JWehle/gps-seven-seg-clock/README.md

# gps-seven-seg-clock
A large seven segment clock that uses highly accurate GPS time.
