JWehle/gps-seven-seg-clock/gps-seven-seg-clock.xlsx

Reference | Qty | Value | Footprint
C1,C2,C5,C6,C8,C9,C10,C11,C13,C15,C16,C17 | 12 | 0.1uF | Capacitor_SMD:C_0603_1608Metric
C3 | 1 | 10nF | Capacitor_SMD:C_0603_1608Metric
C4,C12,C14 | 3 | 10uF | Capacitor_SMD:C_0603_1608Metric
C7 | 1 | 100uF | Capacitor_SMD:CP_Elec_6.3x5.4_Nichicon
D1 | 1 | RED LED | LED_SMD:LED_0603_1608Metric_Pad1.05x0.95mm_HandSolder
D2,D3 | 2 | B5819W | Diode_SMD:D_SOD-123
J1 | 1 | SMA | Connector_Coaxial:SMA_Amphenol_132289_EdgeMount
J2,J3,J7,J8,J10,J11 | 6 | SM09B-GHS-TB | Connector_JST:JST_GH_SM09B-GHS-TB_1x09-1MP_P1.25mm_Horizontal
J5 | 1 | XT30PW-M | Connector_AMASS:AMASS_XT30PW-M_1x02_P2.50mm_Horizontal
J6,J12 | 2 | SM04B-GHS-TB | Connector_JST:JST_GH_SM04B-GHS-TB_1x04-1MP_P1.25mm_Horizontal
J9 | 1 | SM06B-GHS-TB | Connector_JST:JST_GH_SM06B-GHS-TB_1x06-1MP_P1.25mm_Horizontal
L1 | 1 | ferrite | Inductor_SMD:L_0805_2012Metric_Pad1.15x1.40mm_HandSolder
Q2 | 1 | MJD127 | Package_TO_SOT_SMD:TO-252-2
R1 | 1 | 10R | Resistor_SMD:R_0603_1608Metric
R2,R3,R4,R5 | 4 | 2.2K | Resistor_SMD:R_0603_1608Metric
R6,R8,R9,R10 | 4 | 100K | Resistor_SMD:R_0603_1608Metric
R7,R14,R15 | 3 | 1K | Resistor_SMD:R_0603_1608Metric
R11,R16 | 2 | 10K | Resistor_SMD:R_0603_1608Metric
R12 | 1 | 4.99K | Resistor_SMD:R_0603_1608Metric
R13,R17 | 2 | 470R | Resistor_SMD:R_1206_3216Metric
SW1 | 1 | 219-2LPST | Button_Switch_SMD:SW_DIP_SPSTx02_Slide_6.7x6.64mm_W8.61mm_P2.54mm_LowProfile
TP1,TP2,TP3,TP4 | 4 | testpoint5016 | jannett_footprints:TestPoint_Keystone_5016_Vias
U1,U6,U11 | 3 | CAT9555PW | Package_SO:TSSOP-24_4.4x7.8mm_P0.65mm
U2 | 1 | MAX-M10S | RF_GPS:ublox_MAX
U3,U4,U7,U8,U12,U13 | 6 | ULN2003ADR | Package_SO:SOIC-16_3.9x9.9mm_P1.27mm
U5 | 1 | ATmega328PB-A | Package_QFP:TQFP-32_7x7mm_P0.8mm
U9 | 1 | NCP1117-3.3_TO252 | Package_TO_SOT_SMD:TO-252-2
U10 | 1 | AD8676xR | Package_SO:SOIC-8_3.9x4.9mm_P1.27mm
Y1 | 1 | 8MHz | Crystal:Resonator_SMD_Murata_CSTxExxV-3Pin_3.0x1.1mm_HandSoldering
