JWehle/gps-seven-seg-clock/gps-seven-seg-clock-v2.kicad_pcb

## KiCad design gps-seven-seg-clock-v2.kicad_pcb (2026-03-17)

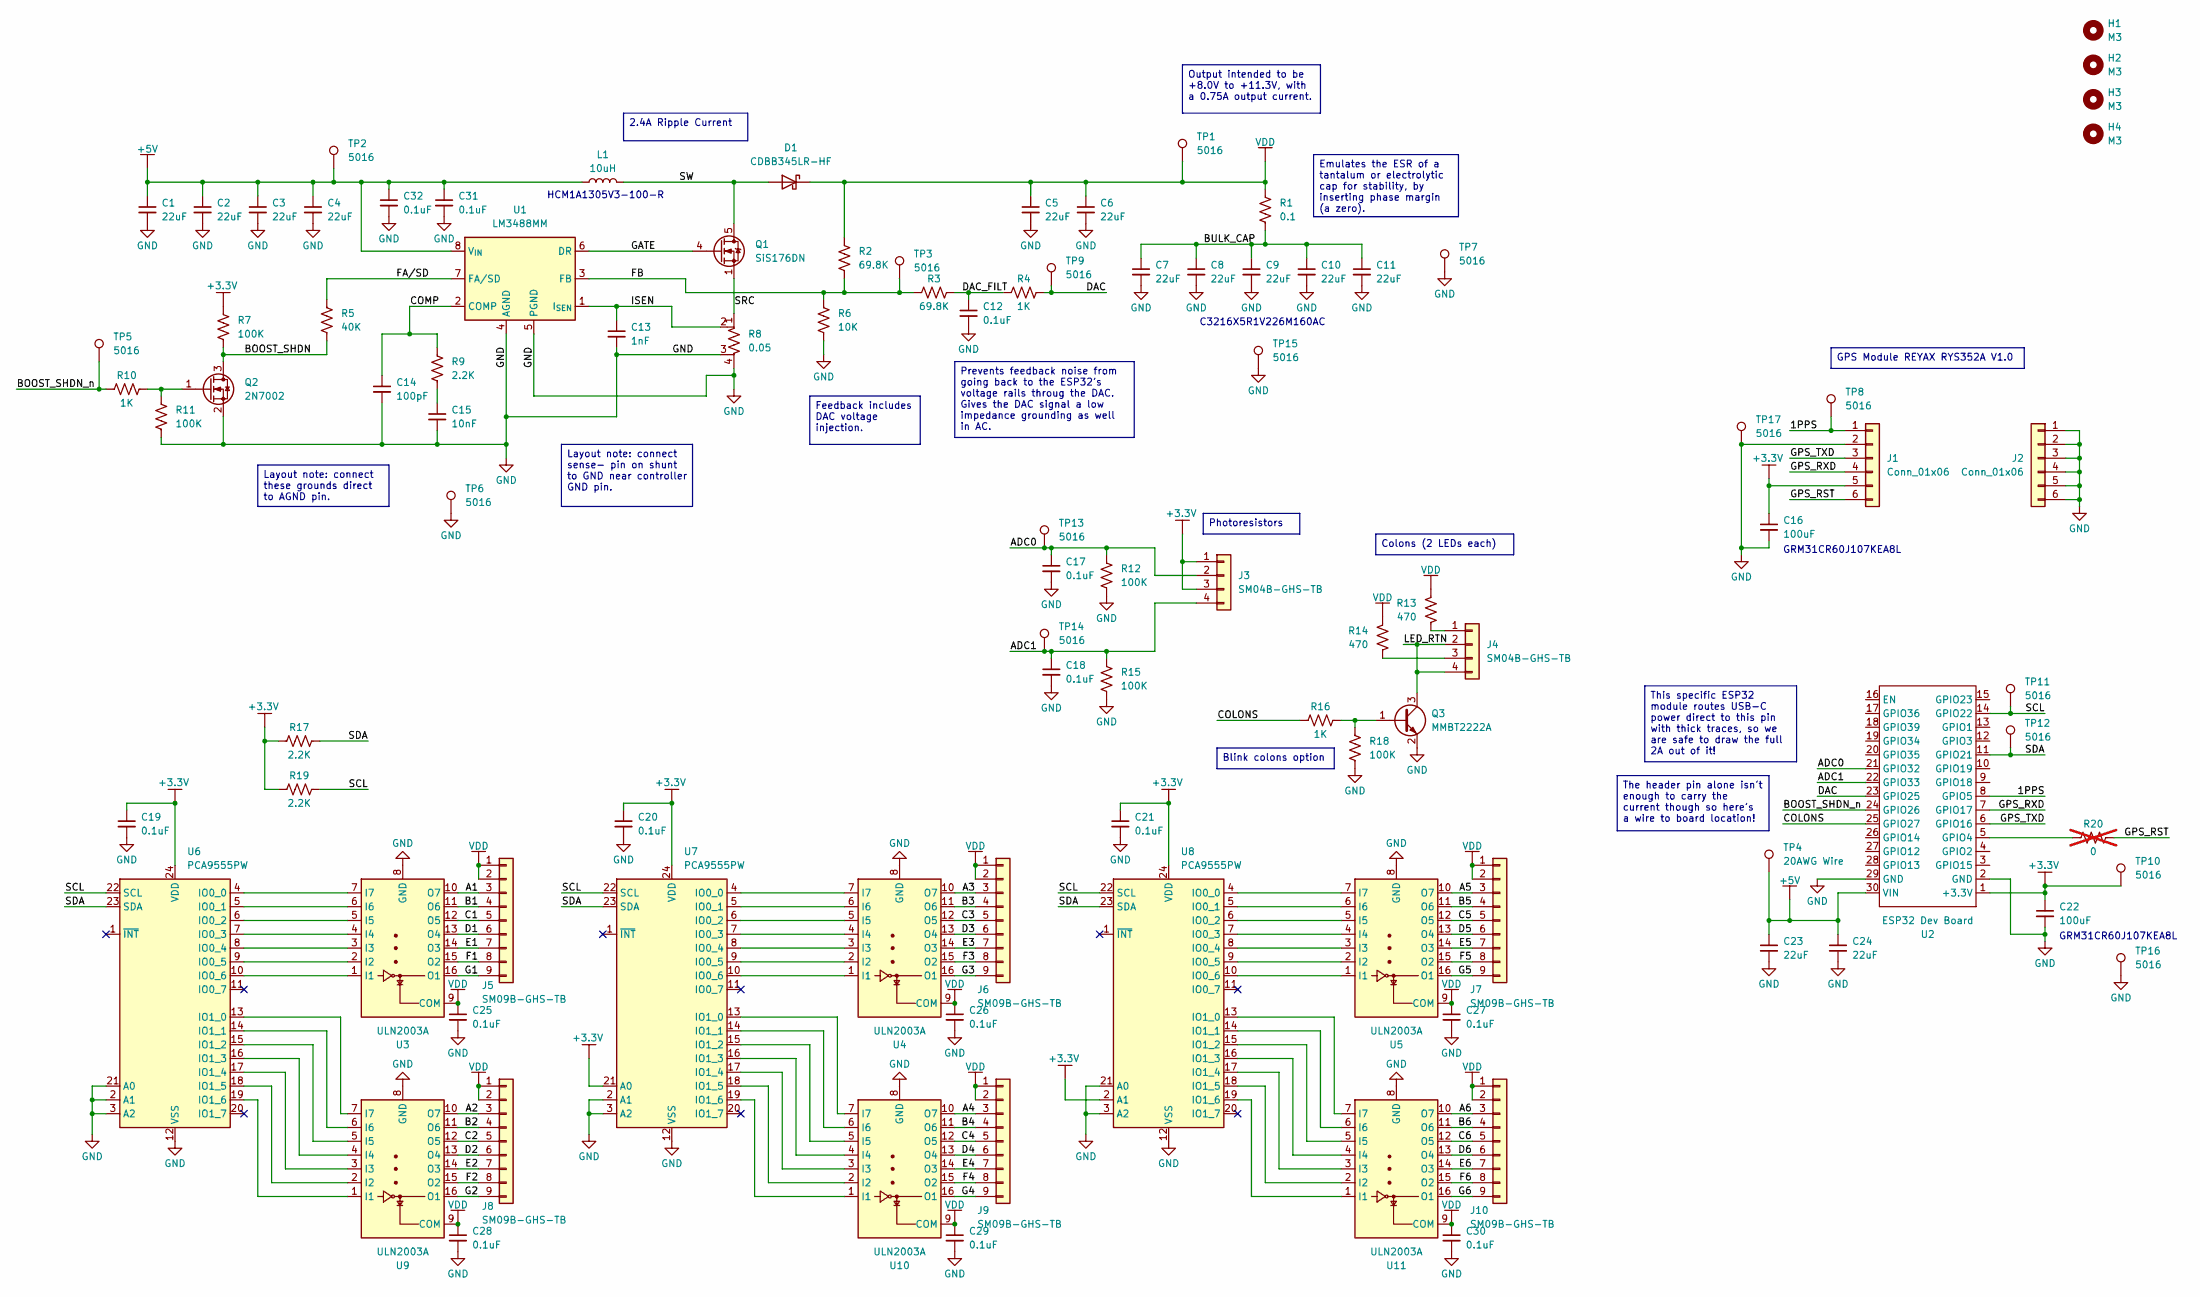
[picture p1: schematic gps-seven-seg-clock-v2.kicad_sch]

Parts:
C1, C2, C3, C4, C5, C6, C7, C8, C9, C10, C11, C23, C24: 22uF; C_1206_3216Metric_Pad1.33x1.80mm_HandSolder
C12, C17, C18, C19, C20, C21, C25, C26, C27, C28, C29, C30, C31, C32: 0.1uF; C_0603_1608Metric
C13: 1nF; C_0603_1608Metric
C14: 100pF; C_0603_1608Metric
C15: 10nF; C_0603_1608Metric
C16, C22: 100uF; C_1206_3216Metric_Pad1.33x1.80mm_HandSolder
D1: CDBB345LR-HF; D_SMB
H1, H2, H3, H4: M3; MountingHole_3.2mm_M3
J1, J2: Conn_01x06; PinSocket_1x06_P2.54mm_Vertical
J3, J4: SM04B-GHS-TB; JST_GH_SM04B-GHS-TB_1x04-1MP_P1.25mm_Horizontal
J5, J6, J7, J8, J9, J10: SM09B-GHS-TB; JST_GH_SM09B-GHS-TB_1x09-1MP_P1.25mm_Horizontal
L1: 10uH; L_Sunlord_MWSA1204S-100
Q1: SiS176DN; Vishay_PowerPAK_1212-8_Single
Q2: 2N7002; SOT-23
Q3: MMBT2222A; SOT-23
R1: 0.1; R_1206_3216Metric
R2, R3: 69.8K; R_0603_1608Metric
R4, R10, R16: 1K; R_0603_1608Metric
R5: 40K; R_0603_1608Metric
R6: 10K; R_0603_1608Metric
R7, R11, R12, R15, R18: 100K; R_0603_1608Metric
R8: 0.05; R_Shunt_Vishay_WSK2512_6332Metric_T2.21mm
R9, R17, R19: 2.2K; R_0603_1608Metric
R13, R14: 470; R_1206_3216Metric
R20: 0; R_0603_1608Metric; not fitted
TP1, TP2, TP6, TP7, TP10, TP15, TP16, TP17: 5016; TestPoint_Keystone_5016_Vias
TP3, TP5, TP8, TP9, TP11, TP12, TP13, TP14: 5016; TestPoint_Keystone_5016_Compact
TP4: 20AWG Wire; TestPoint_THTPad_D2.0mm_Drill1.0mm
U1: LM3488MM; VSSOP-8_3x3mm_P0.65mm
U2: ESP32 Dev Board; ESP32_MODULE
U3, U4, U5, U9, U10, U11: ULN2003A; SOIC-16_3.9x9.9mm_P1.27mm
U6, U7, U8: PCA9555PW; TSSOP-24_4.4x7.8mm_P0.65mm

Connections:
+3.3V: C16.1, C19.1, C20.1, C21.1, C22.1, J1.5, J3.1, J3.3, R7.1, R17.1, R19.1, TP10.1, U2.1 (+3.3V), U6.24 (VDD), U7.21 (A0), U7.24 (VDD), U8.2 (A1), U8.24 (VDD)
+5V: C1.1, C2.1, C3.1, C4.1, C23.1, C24.1, C31.1, C32.1, L1.1, TP2.1, TP4.1, U1.8 (V_{IN}), U2.30 (VIN)
/1PPS: J1.1, TP8.1, U2.8 (GPIO5)
/A1: J5.3, U3.10 (O7)
/A2: J8.3, U9.10 (O7)
/A3: J6.3, U4.10 (O7)
/A4: J9.3, U10.10 (O7)
/A5: J7.3, U5.10 (O7)
/A6: J10.3, U11.10 (O7)
/ADC0: C17.1, J3.2, R12.1, TP13.1, U2.21 (GPIO32)
/ADC1: C18.1, J3.4, R15.1, TP14.1, U2.22 (GPIO33)
/B1: J5.4, U3.11 (O6)
/B2: J8.4, U9.11 (O6)
/B3: J6.4, U4.11 (O6)
/B4: J9.4, U10.11 (O6)
/B5: J7.4, U5.11 (O6)
/B6: J10.4, U11.11 (O6)
/BOOST_SHDN: Q2.3 (D), R5.2, R7.2
/BOOST_SHDN_n: R10.1, TP5.1, U2.24 (GPIO26)
/BULK_CAP: C7.1, C8.1, C9.1, C10.1, C11.1, R1.2
/C1: J5.5, U3.12 (O5)
/C2: J8.5, U9.12 (O5)
/C3: J6.5, U4.12 (O5)
/C4: J9.5, U10.12 (O5)
/C5: J7.5, U5.12 (O5)
/C6: J10.5, U11.12 (O5)
/COLONS: R16.1, U2.25 (GPIO27)
/COMP: C14.1, R9.1, U1.2 (COMP)
/D1: J5.6, U3.13 (O4)
/D2: J8.6, U9.13 (O4)
/D3: J6.6, U4.13 (O4)
/D4: J9.6, U10.13 (O4)
/D5: J7.6, U5.13 (O4)
/D6: J10.6, U11.13 (O4)
/DAC: R4.2, TP9.1, U2.23 (GPIO25)
/DAC_FILT: C12.1, R3.2, R4.1
/E1: J5.7, U3.14 (O3)
/E2: J8.7, U9.14 (O3)
/E3: J6.7, U4.14 (O3)
/E4: J9.7, U10.14 (O3)
/E5: J7.7, U5.14 (O3)
/E6: J10.7, U11.14 (O3)
/F1: J5.8, U3.15 (O2)
/F2: J8.8, U9.15 (O2)
/F3: J6.8, U4.15 (O2)
/F4: J9.8, U10.15 (O2)
/F5: J7.8, U5.15 (O2)
/F6: J10.8, U11.15 (O2)
/FA/SD: R5.1, U1.7 (FA/SD)
/FB: R2.2, R3.1, R6.1, TP3.1, U1.3 (FB)
/G1: J5.9, U3.16 (O1)
/G2: J8.9, U9.16 (O1)
/G3: J6.9, U4.16 (O1)
/G4: J9.9, U10.16 (O1)
/G5: J7.9, U5.16 (O1)
/G6: J10.9, U11.16 (O1)
/GATE: Q1.4 (G), U1.6 (DR)
/GPS_RST: J1.6, R20.2
/GPS_RXD: J1.4, U2.7 (GPIO17)
/GPS_TXD: J1.3, U2.6 (GPIO16)
/ISEN: C13.1, R8.2, U1.1 (I_{SEN})
/LED_RTN: J4.2, J4.4, Q3.3 (C)
/SCL: R19.2, TP11.1, U2.14 (GPIO22), U6.22 (SCL), U7.22 (SCL), U8.22 (SCL)
/SDA: R17.2, TP12.1, U2.11 (GPIO21), U6.23 (SDA), U7.23 (SDA), U8.23 (SDA)
/SRC: Q1.1 (S), Q1.2 (S), Q1.3 (S), R8.1
/SW: D1.2 (A), L1.2, Q1.5 (D)
GND: C1.2, C2.2, C3.2, C4.2, C5.2, C6.2, C7.2, C8.2, C9.2, C10.2, C11.2, C12.2, C13.2, C14.2, C15.2, C16.2, C17.2, C18.2, C19.2, C20.2, C21.2, C22.2, C23.2, C24.2, C25.2, C26.2, C27.2, C28.2, C29.2, C30.2, C31.2, C32.2, J1.2, J2.1, J2.2, J2.3, J2.4, J2.5, J2.6, Q2.2 (S), Q3.2 (E), R6.2, R8.3, R8.4, R11.2, R12.2, R15.2, R18.2, TP6.1, TP7.1, TP15.1, TP16.1, TP17.1, U1.4 (AGND), U1.5 (PGND), U2.2 (GND), U2.29 (GND), U3.8 (GND), U4.8 (GND), U5.8 (GND), U6.2 (A1), U6.3 (A2), U6.12 (VSS), U6.21 (A0), U7.2 (A1), U7.3 (A2), U7.12 (VSS), U8.3 (A2), U8.12 (VSS), U8.21 (A0), U9.8 (GND), U10.8 (GND), U11.8 (GND)
unnamed: C15.1, R9.2
unnamed: J4.1, R13.2
unnamed: J4.3, R14.2
unnamed: Q2.1 (G), R10.2, R11.1
unnamed: Q3.1 (B), R16.2, R18.1
unnamed: R20.1, U2.5 (GPIO4)
unnamed: U3.1 (I1), U6.10 (IO0_6)
unnamed: U3.2 (I2), U6.9 (IO0_5)
unnamed: U3.3 (I3), U6.8 (IO0_4)
unnamed: U3.4 (I4), U6.7 (IO0_3)
unnamed: U3.5 (I5), U6.6 (IO0_2)
unnamed: U3.6 (I6), U6.5 (IO0_1)
unnamed: U3.7 (I7), U6.4 (IO0_0)
unnamed: U4.1 (I1), U7.10 (IO0_6)
unnamed: U4.2 (I2), U7.9 (IO0_5)
unnamed: U4.3 (I3), U7.8 (IO0_4)
unnamed: U4.4 (I4), U7.7 (IO0_3)
unnamed: U4.5 (I5), U7.6 (IO0_2)
unnamed: U4.6 (I6), U7.5 (IO0_1)
unnamed: U4.7 (I7), U7.4 (IO0_0)
unnamed: U5.1 (I1), U8.10 (IO0_6)
unnamed: U5.2 (I2), U8.9 (IO0_5)
unnamed: U5.3 (I3), U8.8 (IO0_4)
unnamed: U5.4 (I4), U8.7 (IO0_3)
unnamed: U5.5 (I5), U8.6 (IO0_2)
unnamed: U5.6 (I6), U8.5 (IO0_1)
unnamed: U5.7 (I7), U8.4 (IO0_0)
unnamed: U6.13 (IO1_0), U9.7 (I7)
unnamed: U6.14 (IO1_1), U9.6 (I6)
unnamed: U6.15 (IO1_2), U9.5 (I5)
unnamed: U6.16 (IO1_3), U9.4 (I4)
unnamed: U6.17 (IO1_4), U9.3 (I3)
unnamed: U6.18 (IO1_5), U9.2 (I2)
unnamed: U6.19 (IO1_6), U9.1 (I1)
unnamed: U7.19 (IO1_6), U10.1 (I1)
unnamed: U7.18 (IO1_5), U10.2 (I2)
unnamed: U7.17 (IO1_4), U10.3 (I3)
unnamed: U7.16 (IO1_3), U10.4 (I4)
unnamed: U7.15 (IO1_2), U10.5 (I5)
unnamed: U7.14 (IO1_1), U10.6 (I6)
unnamed: U7.13 (IO1_0), U10.7 (I7)
unnamed: U8.19 (IO1_6), U11.1 (I1)
unnamed: U8.18 (IO1_5), U11.2 (I2)
unnamed: U8.17 (IO1_4), U11.3 (I3)
unnamed: U8.16 (IO1_3), U11.4 (I4)
unnamed: U8.15 (IO1_2), U11.5 (I5)
unnamed: U8.14 (IO1_1), U11.6 (I6)
unnamed: U8.13 (IO1_0), U11.7 (I7)
VDD: C5.1, C6.1, C25.1, C26.1, C27.1, C28.1, C29.1, C30.1, D1.1 (K), J5.1, J5.2, J6.1, J6.2, J7.1, J7.2, J8.1, J8.2, J9.1, J9.2, J10.1, J10.2, R1.1, R2.1, R13.1, R14.1, TP1.1, U3.9 (COM), U4.9 (COM), U5.9 (COM), U9.9 (COM), U10.9 (COM), U11.9 (COM)

Notes on the sheet:
GRM31CR60J107KEA8L
C3216X5R1V226M160AC
HCM1A1305V3-100-R
2.4A Ripple Current
Feedback includes DAC voltage injection.
Photoresistors
The header pin alone isn't enough to carry the current though so here's a wire to board location!
Layout note: connect sense- pin on shunt to GND near controller GND pin.
Blink colons option
GPS Module REYAX RYS352A V1.0
Emulates the ESR of a tantalum or electrolytic cap for stability, by inserting phase margin (a zero).
Colons (2 LEDs each)
Output intended to be +8.0V to +11.3V, with a 0.75A output current.
This specific ESP32 module routes USB-C power direct to this pin with thick traces, so we are safe to draw the full 2A out of it!
Prevents feedback noise from going back to the ESP32's voltage rails throug the DAC. Gives the DAC signal a low impedance grounding as well in AC.
Layout note: connect these grounds direct to AGND pin.

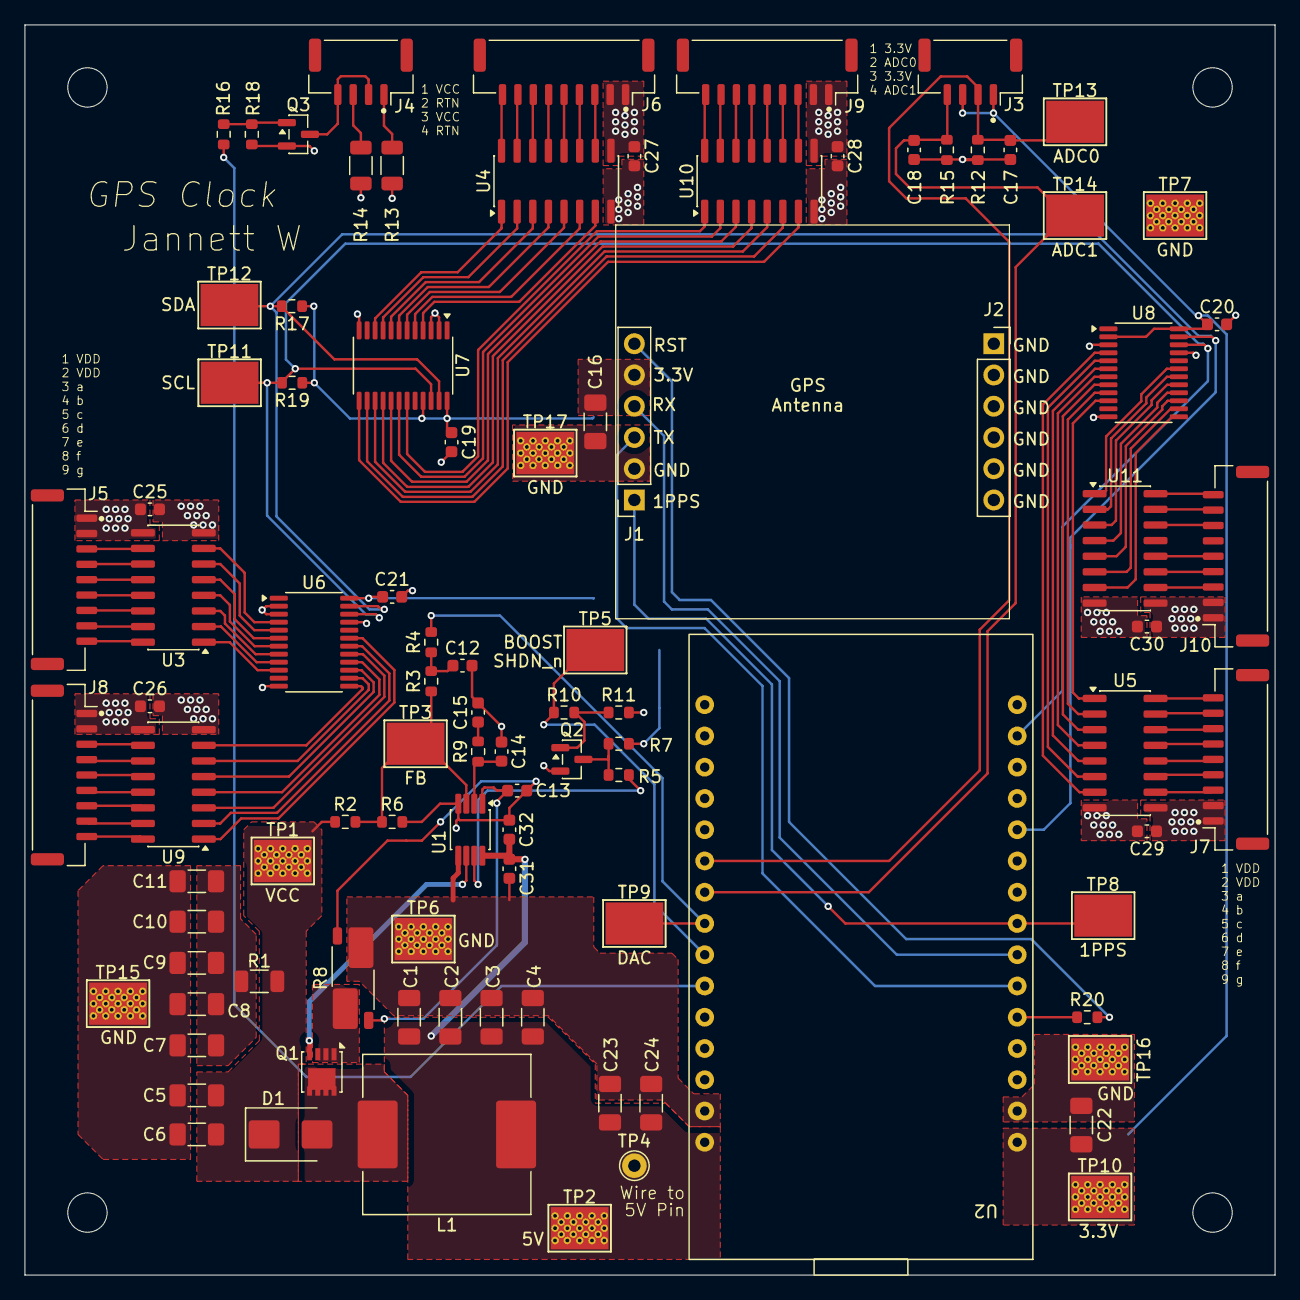
[picture p2: board gps-seven-seg-clock-v2.kicad_pcb from above]

Board: 4 copper layers, 101.6 x 101.6 mm, 99 parts (0 on the bottom side), 116 nets.
