JWehle/gps-seven-seg-clock/(commit log)

2025-08-18 bom edits
    [gps-seven-seg-clock.xlsx]
2026-02-20 schematic v2
    [gps-seven-seg-clock-v2.kicad_pcb, gps-seven-seg-clock-v2.kicad_sch, gps-seven-seg-clock.kicad_sch]
2026-02-22 sch and layout
    [gps-seven-seg-clock-v2.kicad_pcb, gps-seven-seg-clock-v2.kicad_sch]
2026-03-17 gerbers and layout done
    [gps-seven-seg-clock-v2-B_Cu.gbl, gps-seven-seg-clock-v2-B_Mask.gbs, gps-seven-seg-clock-v2-B_Paste.gbp, gps-seven-seg-clock-v2-B_Silkscreen.gbo, gps-seven-seg-clock-v2-Edge_Cuts.gm1, gps-seven-seg-clock-v2-F_Cu.gtl, gps-seven-seg-clock-v2-F_Mask.gts, gps-seven-seg-clock-v2-F_Paste.gtp]
